azinedine456/PEMFC-Battery-HESS-FCEV-HIL-Simulation-Project/Project Report (French) - Émulation d’un véhicule électrique à stockage.pdf

## Spécialité :

## Génie Électrique - EPRM – I3

2025-2026

## UE - Projet : Réalisation et synthèse EPRM

### 1. Groupe 3

- H. Zinedine ABAYAHIA
- Melvyn TOURAILLE VARAMATA
- Aissatou BA

## Émulation d’un véhicule électrique à stockage

## hybride (FCEV HESS)

## - Groupe 3 - Emulateur de Pile à combustible et

## convertisseur Boost -

## Résumé

Ce projet s’inscrit dans le cadre de l’étude et de la modélisation d’une chaîne de traction

hybride associant une pile à combustible à membrane échangeuse de protons (PEMFC) et

une batterie, interfacées par des convertisseurs statiques de puissance. L’objectif principal

est la conception et l’implémentation d’un émulateur de pile à combustible capable de

reproduire fidèlement le comportement électrique d’une PEMFC réelle, tout en permettant

une interaction réaliste avec un bus continu imposé par une batterie.

L’approche retenue repose sur l’utilisation de deux convertisseurs DC/DC distincts : un

convertisseur abaisseur, dédié à l’émulation de la pile à combustible au travers de

différents modèles disponible sous Simscape (conditions nominales), et un convertisseur

élévateur, chargé de contrôler le courant injecté dans le bus continu. Les modèles et lois de

commande ont été développés sous l’environnement MATLAB/Simulink, en tenant

compte des contraintes de stabilité, de performance dynamique et de simplicité de mise en

œuvre en vue d’une future implémentation matérielle.

Les résultats de simulation permettent de valider la structure de commande proposée ainsi

que la séparation fonctionnelle entre l’émulation de la pile et la gestion de l’énergie

injectée dans le bus continu. Ce travail constitue une base solide pour l’extension vers des

modèles dynamiques plus complexes de PEMFC et pour une implémentation

expérimentale sur banc de test.

## Table des matières

2.2.3 | Asservissement du convertisseur Buck – Mode Tension (modèle du premier ordre)14
2.2.4 | Asservissement du convertisseur Buck – Mode Tension (modèle du second ordre) 15

References | 31
Annexe | 32

## Liste des Figures

Figure 1 : Topologie semi-active d’un véhicule FCEV hybride [4] | 7
Figure 2 : Difference entre la topologie "Full-Active" et Semi-Active[4] | 7
Figure 3 Rendement électrique (Li-Ion vs PAC)[5] | 8
Figure 4 : Réaction oxydoréduction d'une PAC MEP [8] | 9
Figure 5 : Caractéristique IV d'une PAC MEP [10] | 12

Figure 6 : Simulateur HIL basé sur le modèle du circuit électrique équivalent (Valable en

région ohmique seulement) [8] | 12
Figure 7 : Schéma global du système d'émulation [4], [12] | 13
Figure 8 : Circuit Buck | 15

Figure 9 : Analyse fréquentielle en boucle ouverte du modèle (Convertisseur + Correcteur)

Conception robuste après avoir agi sur Kp | 17
Figure 10 : Validation du dimensionnement Boost et Buck | 19
Figure 11 : Validation de l'asservissement de tension et de courant | 20

Figure 12 : Système d'émulation sous Simulink. (Le booléen RealData permet de choisir

entre les données fictives (créneaux) ou WLTC) | 20
Figure 13 : Validation du système d'émulation en simulation | 21
Figure 14 : Augmentation de la capacité du condensateur Buck | 21
Figure 15 : Modèle PAC prédéfini (133A nom) | 22
Figure 16 : Modèle PAC Ifcnom=6A | 22
Figure 17 : Alimentation reversible en courant (Réseau DC) | 26
Figure 18 : Émulateur PAC (vue d'ensemble) | 26
Figure 19 : Écran bleu de l'ordinateur lors de l'exécution en temps réel | 27

Figure 20 : Validation du dimensionnement avant le câblage final (Courant boost à gauche,

## Nomenclature

PWM/MLI | Pulse With Modulation/ Modulation de largeur d’impulsion
HESS | Hybrid Energy Storage System
FCEV | Fuel Cell Electric Vehicles
PAC | Pile à combustible
MEP | Pile à combustible à membrane échangeuse de protons (PEM en Anglais)

## Introduction

La transition vers des systèmes de transport à faibles émissions a conduit à un intérêt

croissant pour les véhicules électriques à hydrogène, appelés Fuel Cell Electric Vehicles

(FCEV). Ces architectures reposent généralement sur l’association de plusieurs sources

d’énergie au sein d’un système de stockage hybride (Hybrid Energy Storage System –

HESS), combinant une pile à combustible et une batterie électrochimique. Cette

hybridation permet de tirer parti des caractéristiques complémentaires de chaque source

afin de répondre aux contraintes dynamiques de la traction électrique tout en limitant les

sollicitations de la pile à combustible.

Dans un contexte de recherche et d’enseignement, l’expérimentation directe sur un

véhicule réel ou sur une pile à combustible physique reste complexe et coûteuse. Une

solution intermédiaire consiste alors à développer un émulateur de pile à combustible à

échelle réduite, permettant de reproduire son comportement électrique sans recourir à un

dispositif réel.

Ce projet s’inscrit dans cette démarche et vise la conception et la commande d’un

émulateur de pile à combustible destiné à une application de type FCEV, intégré à un

environnement simplifié représenté par un bus continu idéal.

Ce projet vise à concevoir un émulateur de PEMFC intégré dans une chaîne de traction

hybride, en mettant l’accent sur une modélisation réaliste du comportement électrique et

sur une architecture de commande claire et modulaire. L’approche adoptée dissocie

l’émulation de la tension de la pile et le contrôle du courant injecté dans le bus continu, ce

dernier ayant une tension imposée par la batterie.

L’ensemble des travaux est réalisé sous MATLAB/Simulink, avec une attention

particulière portée à la stabilité en boucle fermée, à la robustesse face aux variations de

charge et à la compatibilité avec une implémentation matérielle future.

## Chapitre 1. Contexte

## 1.1 Structure des véhicules électriques à stockage hybride (FCEV HESS)

Dans une architecture FCEV hybride semi-active, la batterie est directement connectée au

bus continu et assure le maintien de la tension du réseau ainsi que la fourniture de

puissance lors des transitoires rapides de courant imposés par le cycle de conduite (voir

Figure 1 et la Figure 2). La batterie permet également la récupération de l’énergie cinétique

lors des phases de freinage régénératif, ce qui impose un fonctionnement bidirectionnel en

courant [1].

La pile à combustible, alimentée par un réservoir d’hydrogène, est destinée à fournir une

puissance moyenne quasi constante et unidirectionnelle en courant. Ce mode de

fonctionnement permet d’optimiser le rendement de la pile et de limiter les sollicitations

dynamiques susceptibles d’affecter sa durée de vie [2], [3]. L’interface entre la pile à

combustible et le bus continu est assurée par un convertisseur Boost, dont le rôle est à la

fois d’adapter le niveau de tension de la PAC au réseau DC et d’asservir le courant prélevé

à la pile [4].

La chaîne de traction consomme l’énergie fournie par la pile à combustible et la batterie

conformément à la stratégie de gestion des flux de puissance mise en œuvre. En phase de

freinage régénératif, l’énergie récupérée est réinjectée vers la batterie via le bus continu.

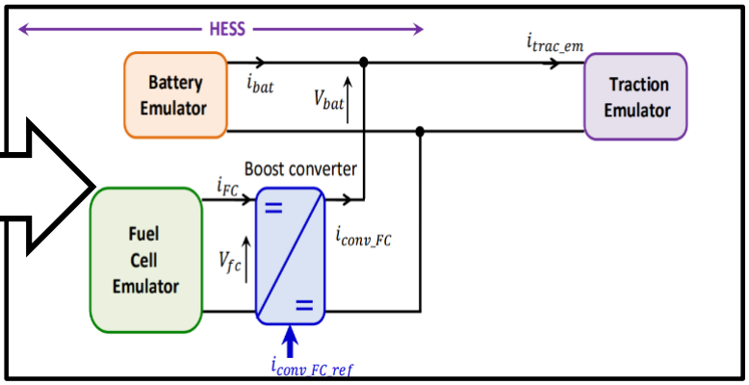
[picture p1: figure]
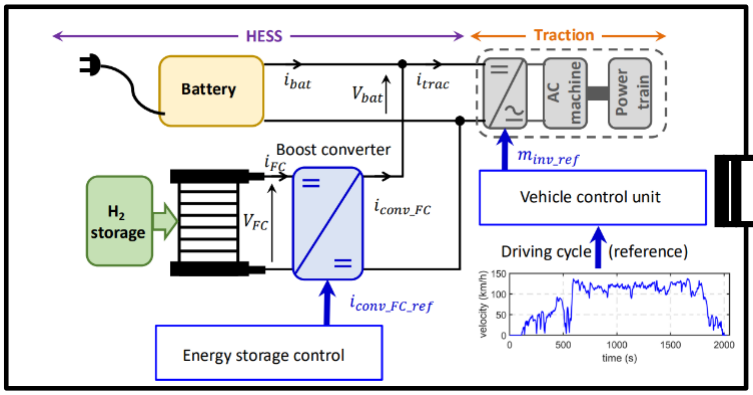
[picture p2: figure]

Figure 1 : Topologie semi-active d’un véhicule FCEV hybride [4].

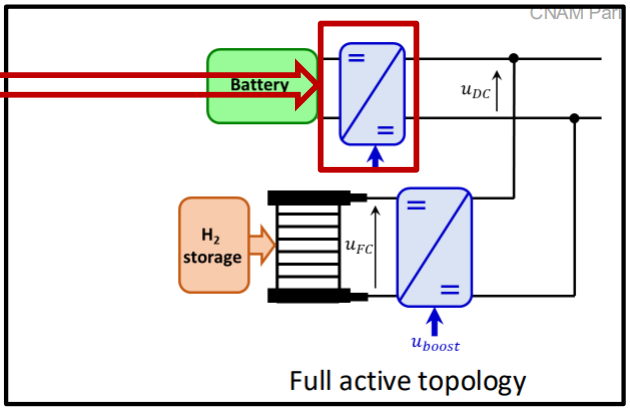
[picture p3: figure]
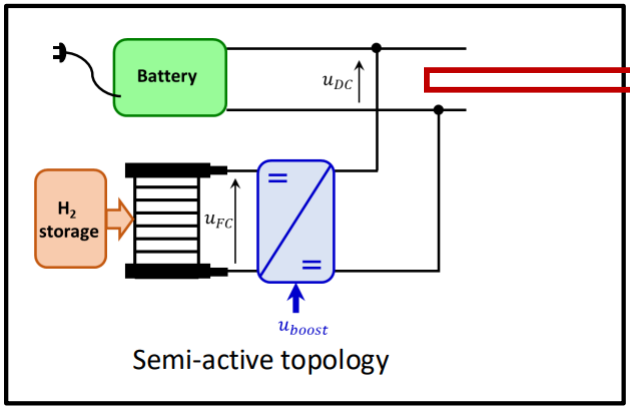
[picture p4: figure]

Figure 2 : Difference entre la topologie "Full-Active" et Semi-Active[4].

## 1.2 Rôle de la pile à combustible vis-à-vis de la batterie

Dans un FCEV HESS, la répartition des rôles entre la pile à combustible et la batterie est

dictée par leurs caractéristiques intrinsèques. La batterie Li-Ion présente un très bon

rendement énergétique et une capacité à répondre rapidement aux variations de courant, ce

qui la rend adaptée à la compensation des pics de puissance liés aux accélérations et aux

phases de récupération d’énergie au freinage [5]. En revanche, sa densité énergétique reste

limitée (par rapport à la PAC) et son vieillissement est fortement dépendant des cycles de

charge et de décharge [5], [6].

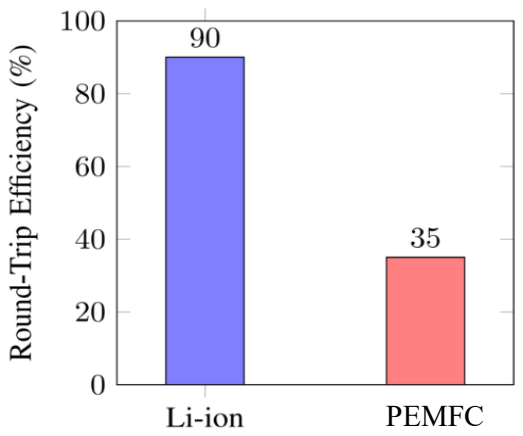
[picture p5: figure]
PEMFC
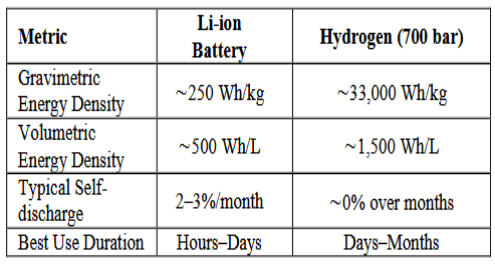
[picture p6: figure]

La pile à combustible MEP, quant à elle, offre une densité énergétique élevée grâce à

l’hydrogène, mais présente une dynamique lente et une sensibilité marquée aux variations

rapides de courant [7]. Pour cette raison, il est généralement admis que la PAC doit

fonctionner autour d’un point de fonctionnement relativement stable, fournissant un flux de

puissance quasi constant. Toute sollicitation dynamique excessive est susceptible

d’entraîner une dégradation accélérée des performances électrochimiques et mécaniques de

la pile ce qui est lié majoritairement à la dégradation du catalyseur de la MEP [2], [3].

Dans l’architecture étudiée, la batterie assure donc le maintien du bus continu et la gestion

des transitoires, tandis que la pile à combustible alimente le système sur le long terme.

Cette complémentarité justifie le stockage hybride malgré la complexification du groupe

motopropulseur.

Figure 3 Rendement électrique (Li-Ion vs PAC)[5].

Tableau 1 : Comparaison entre la densité de puissance des batteries LI-ION avec les PAC MEP [5].

## Chapitre 2. Partie théorique

## 2.1 Modélisation de la pile à combustible PEM (conditions nominales)

La modélisation de la pile à combustible constitue une étape essentielle pour le

développement d’un émulateur réaliste. Dans le cadre de ce projet, la modélisation est

réalisée sous conditions nominales de fonctionnement, sans prise en compte explicite des

phénomènes de dégradation liés aux ondulations de courant ou au vieillissement à long

terme.

### 2.1.1 Modèle complet, réactions électrochimiques

Une pile à combustible PEM repose sur la réaction électrochimique entre l’hydrogène et l’oxygène pour produire de l’électricité, de la chaleur et de l’eau. À l’anode, l’hydrogène

est oxydé selon la réaction (voir la Figure 4). Ces réactions dépendent de de la température,

de la pression et de l’humidité relative. Pour cette étude, les conditions nominales de la

cellule avaient été prises et le combustible étant inépuisable afin d’éviter les

problématiques d’approvisionnement et de débit.

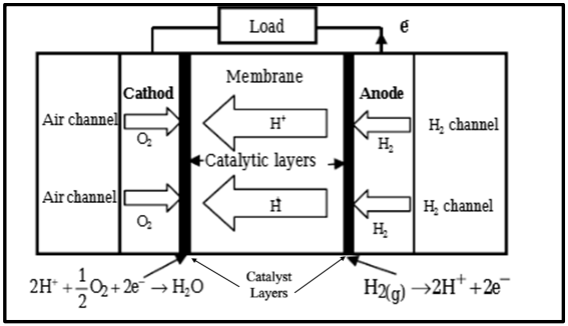
[picture p7: figure]

Figure 4 : Réaction oxydoréduction d'une PAC MEP [8].

La tension idéale de la cellule est déterminée par l’équation de Nernst (2.1.1)[9]

(2.1.1)

Tandis que la tension réelle est affectée par plusieurs chutes de tensions :

Chute d’activation Vact, qui représente la tension requise pour lancer les réactions

chimiques dans l’anode et la cathode (briser et créer les liaisons chimiques) (effet prononcé

pour des courants faibles) [9]

(2.1.2)

La chute de concentration Vcon , qui représente la concentration des gradients créés par la

diffusion des masses depuis les canaux d’approvisionnement jusqu’aux électrodes (effet

prononcé pour des courants forts) [9].

(2.1.3)

La chute de tension ohmique Vohm ,liée a la résistance série des électrodes et de la

membrane MEP[9].

Voℎm = Ifc. Roℎm | (2.1.4)

De plus, la PAC MEP présente un comportement capacitif lié à l’accumulation des charges

entre la membrane et les deux électrodes (double-layer charging effect)[9].

(2.1.5)

(2.1.6)

La tension aux bornes de la PAC est déterminée par l’équation

(2.1.7)

Paramètres électriques globaux

Paramètre | Symbole | Définition
Tension de la pile | Vfc | Tension de sortie de la pile à combustible PEM
Courant de la pile | Ifc | Courant délivré par la pile
Courant limite | Il | Courant maximal atteignable lorsque la réaction est limitée par le transport de matière
Courant d’échange | I0 | Courant électrochimique à l’équilibre

Paramètres thermodynamiques et constants physiques

Paramètre | Symbole | Définition

Paramètre | Symbole | Définition
Constante de Faraday | F | Charge électrique par mole d’électrons (96485 C/mol)
Constante des gaz parfaits | R | Constante universelle des gaz
Température de fonctionnement | T | Température de la pile PEM

Paramètres liés aux pressions et aux gaz réactifs

Paramètre | Symbole | Définition
Pression de l’hydrogène | PH2 | Pression partielle de l’hydrogène à l’anode
Pression de l’oxygène | PO2 | Pression partielle de l’oxygène au cathode
Pression de l’eau | PH2O | Pression partielle de la vapeur d’eau
Constantes expérimentales | B1 , B2

### 2.1.2 Modèle courant–tension (I–V)

Dans une optique d’émulation temps réel, un modèle simplifié basé sur la caractéristique

courant–tension de la pile est souvent privilégié. Cette caractéristique présente trois zones

principales :

- La zone d’activation, dominée par les pertes cinétiques aux faibles courants ;
- La zone ohmique, où la tension décroît de manière quasi linéaire avec le courant ;
- La zone de concentration, associée aux limitations de transport de masse à forts

courants.

Les zones d’activation et de concentration correspondent à des régimes de fonctionnement

à éviter, car elles entraînent une baisse significative du rendement et une sollicitation

accrue de la pile [10], [11]. Le comportement global de la PAC peut être assimilé à une

simple source idéale avec une résistance série en région ohmique ou un « Look up » 1D

entre le courant et la tension sur la totalité de la plage de fonctionnement. Cela dit, les

caractéristiques courant-tension ne suffisent pas pour modéliser la dynamique de la pile

[1], [5], [7].

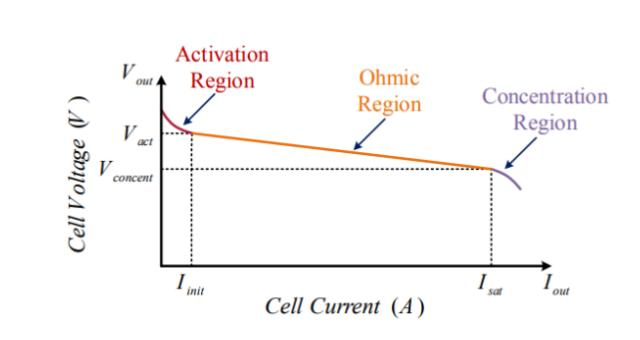
[picture p8: figure]

Figure 5 : Caractéristique IV d'une PAC MEP [10].

## 2.2 Émulateurs de pile à combustible

Un émulateur de pile à combustible vise à reproduire le comportement électrique d’une

PAC réelle à l’aide de sources électriques pilotées, des convertisseurs statiques ou des

circuits électriques spécialisés. Plusieurs approches sont recensées dans la littérature, allant

de modèles purement électriques basés sur des circuits équivalents à des structures plus

complexes intégrant des modèles dynamiques avancés.

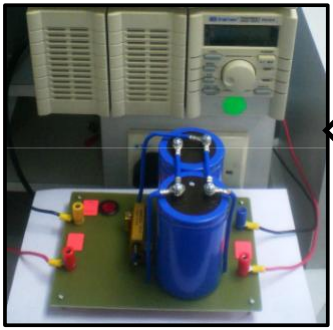
[picture p9: figure]
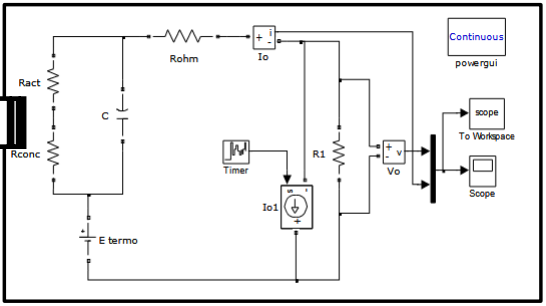
[picture p10: figure]

Afin de modéliser la dynamique de la PAC, et compte tenu du fait que la capacité d’un

MEP typique est de l’ordre du farad (environ 1 F [8]), ainsi que de l’indisponibilité de

condensateurs de telles valeurs en salle de travaux pratiques, l’émulation est réalisée dans

ce projet à l’aide de convertisseurs DC–DC commandés. Ces convertisseurs permettent

d’imposer une tension ou un courant conforme au modèle de la PAC, tout en assurant une

interface efficace avec le bus continu du HESS.

### 2.2.1 Structure retenue pour l’émulation (Système PAC – Bus DC)

L’architecture retenue est un convertisseur Buck asservi en tension associé a un boost

asservi en courant et connecté au bus DC représenté par une source idéale (voir la Figure

7).

Figure 6 : Simulateur HIL basé sur le modèle du circuit électrique équivalent (Valable en région ohmique seulement) [8].

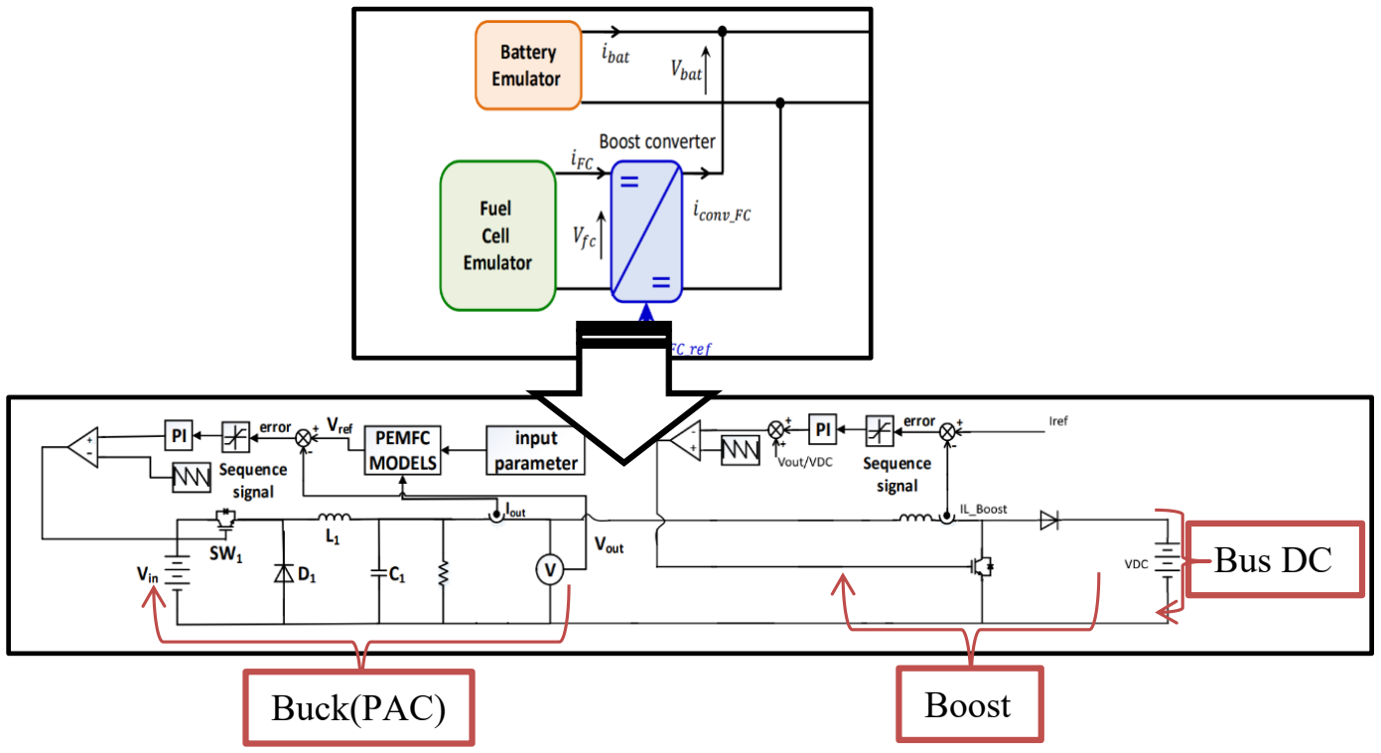
[picture p11: figure]
Buck(PAC); Boost; Bus DC

Cette structure présente l’avantage de coupler dynamiquement les courants des deux

convertisseurs. En effet, le courant absorbé par le convertisseur Boost est directement lié

au courant circulant dans l’inductance du convertisseur Buck. Par conséquent,

l’asservissement de cette grandeur permet indirectement de contrôler le courant du Buck,

ce qui a conduit au choix d’une commande en mode tension afin de simplifier la structure

de contrôle globale.

Néanmoins, cette architecture présente un inconvénient majeur : l’absence de protection

intrinsèque contre les courts-circuits du côté du condensateur de sortie du convertisseur

Buck.

### 2.2.2 Dimensionnement des composants convertisseur Buck (CCM

Seulement)

Le dimensionnement des composants passifs du convertisseur Buck est réalisé à partir des

contraintes sur les ondulations de courant dans l’inductance et sur les ondulations de

tension aux bornes du condensateur de sortie.

L’expression de l’ondulation de courant dans l’inductance du convertisseur Buck peut être

établie à partir du principe d’équilibre volt-seconde appliqué à l’inductance (voir (2.1.8)).

ΔILbuck =

(1 − αΔmax)αΔmaxEbuck

Lbuckfdec

(2.1.8)

Figure 7 : Schéma global du système d'émulation [4], [12]

L’expression de l’ondulation de tension aux bornes du condensateur de sortie peut être

obtenue à partir du principe d’équilibre ampère-seconde appliqué au condensateur, en

intégrant le courant capacitif sur une demi-période de découpage (voir (2.1.9)).

ΔVSbuck =

ΔILbuck

8Cbuckfdec

(2.1.9)

Paramètres

ParamètreDescription

ΔILbuck | Ondulation de courant dans l'inductance du convertisseur buck.
αΔmax | Facteur de modulation lié à l’amplitude maximale de l’ondulation du courant.
Ebuck | Tension d'entrée du convertisseur buck.
Lbuck | Inductance du convertisseur buck.
fdec | Fréquence de découpage (ou fréquence de commutation) du convertisseur.
ΔVSbuck | Ondulation de tension aux bornes du condensateur de sortie.
Cbuck | Capacité du condensateur de sortie du convertisseur buck.

### 2.2.3 Asservissement du convertisseur Buck – Mode Tension (modèle du

premier ordre)

Certaines hypothèses doivent être posées afin de modéliser un circuit Buck comme un

système du premier ordre.

Hypothèses et assertions :

1. Modèle au sens des valeurs moyennes (tension aux bornes de la diode vaut α(t). E).
2. Cbuck suffisamment grand afin de pouvoir négliger les ondulations de tension.
3. Dynamique du condensateur négligée durant une période de découpage (<ic> =ic=0

et Il=Il’ voir la Figure 8).

4. Le courant tiré par le convertisseur boost est considéré comme une perturbation.

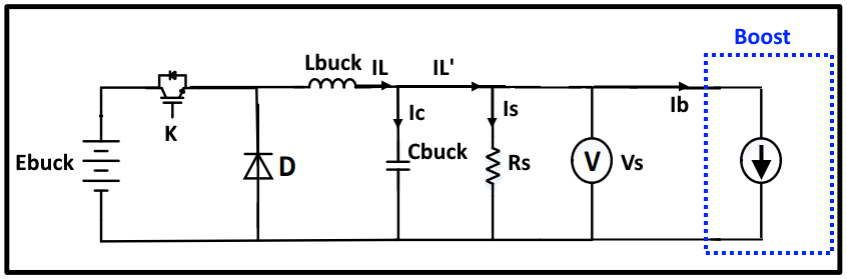
[picture p12: figure]

Figure 8 : Circuit Buck.

En prenant en compte les hypothèses ci-dessus, l’expréssion de la tension peut etre établie

comme suit

Vs(s) =

ERs
Rs + RL
L
Rs + RL

s + 1

α(s) −

RLRs
Rs + RL

(

L
RL

s + 1)

L
RL +Rs

s +1

Ib(s)

(2.1.10)

En négligeant la perturbation, voici la fonction de transfert du système à asservir devient :

Vs(s)
α(s)

|Ib(s)=0 =

ERs
Rs + RL
L
Rs + RL

s + 1

=

Kbuck

τbucks + 1

(2.1.11)

En employant la méthode d’annulation pole-zéro, les gains peuvent être calculés pour un

correcteur PI afin d’imposer un temps de réponse TR5% qui répond au cahier des charges.
{
Kibuck =

3

TR5%buckKbuck
Kpbuck = τbuckKibuck

(2.1.12)

Cette méthode présente toutefois plusieurs inconvénients. En premier lieu, aucune valeur

de la résistance série Rs ne permet de garantir formellement que le convertisseur se

comporte strictement comme un système du premier ordre, comme discuté à la section

2.2.4. De plus, il n’existe pas de critère permettant de déterminer une valeur optimale de

Rsassurant une réduction significative de l’impact des perturbations sans dégrader le

rendement du convertisseur. En pratique, cela conduit à l’utilisation d’une résistance Rsde

faible valeur, au prix d’une augmentation des pertes (Courant Is > 2Ib). Enfin, la

dynamique de la perturbation observée expérimentalement diffère de celle anticipée lors de

l’analyse théorique, comme détaillé à la section 3.1.1.

### 2.2.4 Asservissement du convertisseur Buck – Mode Tension (modèle du

second ordre)

Certaines hypothèses doivent être posées afin de modéliser un circuit Buck comme un

système du second ordre sur-amorti.

Hypothèses et assertions :

1. Modèle au sens des valeurs moyennes (tension aux bornes de la diode vaut α(t). E).

A partir des hypothèses précédentes et de la loi des mailles, l’expression de Vs(s) peut

être établie.

Vs(s) =

E

LCs

2 +(

L
Rs + RL) s +

RL
Rs + 1

α(s) −

(

L
RL

s + 1) RL

LCs

2 + (

L
Rs + RL) s +

RL
Rs + 1

Ib(s)

(2.1.13)

Pour RL = 0Ω :

Vs(s) =

E

LCs

2 + (

L
Rs) s + 1

α(s) −

(Ls + 1)

LCs

2 +(

L
Rs) s + 1

Ib(s)

(2.1.14)

L’objectif est d’amortir le système en imposant un coefficient l ≥ 10 afin d’avoir P2 = P1. l

(pole rapide) et donc un comportement semblable à un 1er ordre.

Vs(s)
α(s)

|Ib(s)=0 =

Kbuck ωn²
(s + P1)(s + P1. l)

(2.1.15)

{

ζsur−amortissment =

1
√1 − (
l − 1
l + 1

)

2

Rsoptimal =

1

2ζsur−amortissment √
Lbuck

Cbuck

(2.1.16)

Par la suite, le pôle P1 sera annulé par le pôle Pi =Ki/Kp du correcteur PI (rapport Ki/Kp

fixe). Puis le gain Kp sera employé afin d’agir sur la marge de phase pour satisfaire les

critères suivants (voir la Figure 9) :

- Marge de gain > 6dB
- Marge de phase > 45°

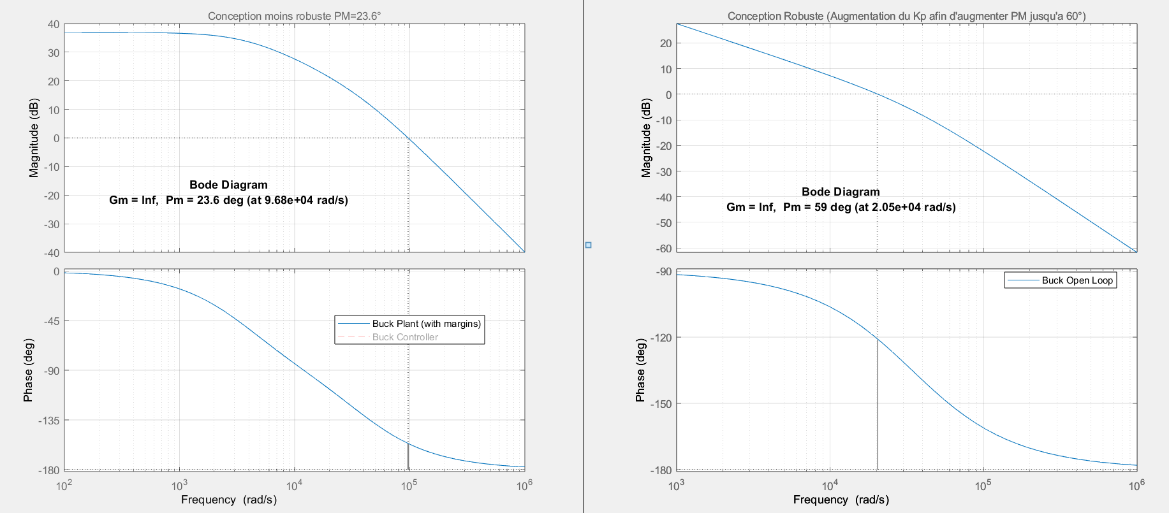
[picture p13: figure]

De plus, le temps de réponse sera analysé afin de vérifier qu’il correspond à notre cahier de

charge.

Cette méthode présente plusieurs avantages, notamment la possibilité de déterminer une

valeur optimale de la résistance Rset de garantir une commande robuste par l’augmentation

de la marge de phase du système. De plus, le modèle représente de manière fidèle la

dynamique de la perturbation 3.1.1.

### 2.2.5 Dimensionnement des composants convertisseur Boost (CCM

Seulement)

Le dimensionnement des composants passifs du convertisseur Boost est réalisé à partir des

contraintes sur les ondulations de courant dans l’inductance.

L’expression de l’ondulation de courant dans l’inductance du convertisseur Boost peut être

établie à partir du principe d’équilibre volt-seconde appliqué à l’inductance

ΔIb =

αVFC

Lboostfdec

(2.1.17)

### 2.2.6 Asservissement du convertisseur Boost

Certaines hypothèses doivent être posées afin d’asservir le circuit Boost.

Hypothèses et assertions :

- Modèle au sens des valeurs moyennes (tension aux bornes du transistor vaut

α(t). VDC).

Figure 9 : Analyse fréquentielle en boucle ouverte du modèle (Convertisseur + Correcteur) Conception robuste après avoir agi sur Kp.

- La dynamique de VDC peut être considérée comme lente ou négligeable vis-à-

vis de la dynamique du courant inductif (système du premier ordre).

En prenant en compte les hypothèses ci-dessus, l’expréssion de la fonction de

transfert du courant peut etre établie comme suit

Ib

(s)
−(2α(s) − 1)

=

VDC
RLboost
L
RLboost

s + 1

=

Kboost
τboosts+1

(2.1.18)

En employant la méthode d’annulation pole-zéro, les gains peuvent être calculés pour un

correcteur PI afin d’imposer un temps de réponse TR5% qui répond au cahier des charges.
{
Kiboost =

3

TR5%boostKboost
Kpboost = τboostKiboost

(2.1.19)

Afin de contrôler directement la puissance fournie par la pile à combustible, le

convertisseur Boost est commandé en courant. La grandeur asservie est le courant inductif

ib, qui correspond au courant prélevé à la PAC. La puissance fournie par la pile est alors

donnée par :

PFC = VFC × ib | (2.1.20)

Cette approche présente plusieurs avantages majeurs. Elle permet d’imposer directement le

point de fonctionnement de la PAC sur sa caractéristique courant–tension ainsi que de

limiter les ondulations de courant côté pile.

## 2.3 Gestion des flux de puissance

La gestion des flux de puissance constitue un prolongement naturel de l’émulateur de

FCEV. Une stratégie de type « charge sustaining » est généralement adoptée, visant à

maintenir l’état de charge de la batterie autour d’une valeur de consigne tout au long du

cycle de conduite [11].

Dans ce cadre, la pile à combustible fournit la puissance moyenne requise par le véhicule,

tandis que la batterie absorbe ou fournit la puissance différentielle liée aux transitoires.

Cette approche permet de reproduire fidèlement le fonctionnement d’un FCEV réel.

## Chapitre 3. Simulation

## 3.1 Méthode de travail

La démarche adoptée repose principalement sur la simulation de l’ensemble du système

afin d’accélérer le prototypage et d’analyser le comportement global avant toute

expérimentation. Des tests unitaires ont également été réalisés pour isoler les sous-

systèmes, faciliter le débogage et sécuriser l’intégration finale.

### 3.1.1 Tests unitaires

Des simulations en boucle ouverte sont réalisées afin de valider le dimensionnement de chaque convertisseur. L’asservissement est ensuite validé en trois étapes successives :

- Buck – mode tension
Cahier des charges : dépassement nul, T5% ≤ 1ms.
- Boost – mode courant
Cahier des charges : dépassement nul, T5% ≤ 1ms.
- Système complet
Validation réalisée avec des profils de puissance fictifs, puis à l’aide d’un cycle WLTC normalisé par rapport au courant nominale de l’émulateur physique (6A).

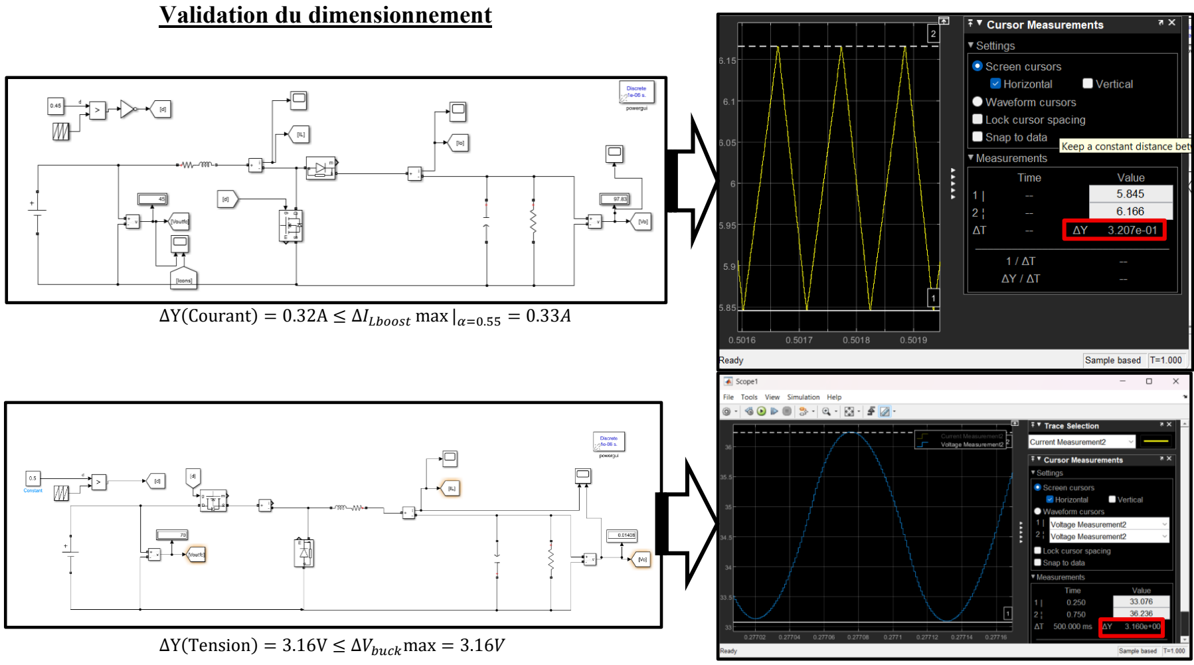
[picture p14: figure]
Validation du dimensionnement; ΔY(Tension) = 3.16V ≤ ΔVbuckmax = 3.16V

ΔY(Courant) = 0.32A ≤ ΔILboost max |α=0.55 = 0.33A

Figure 10 : Validation du dimensionnement Boost et Buck.

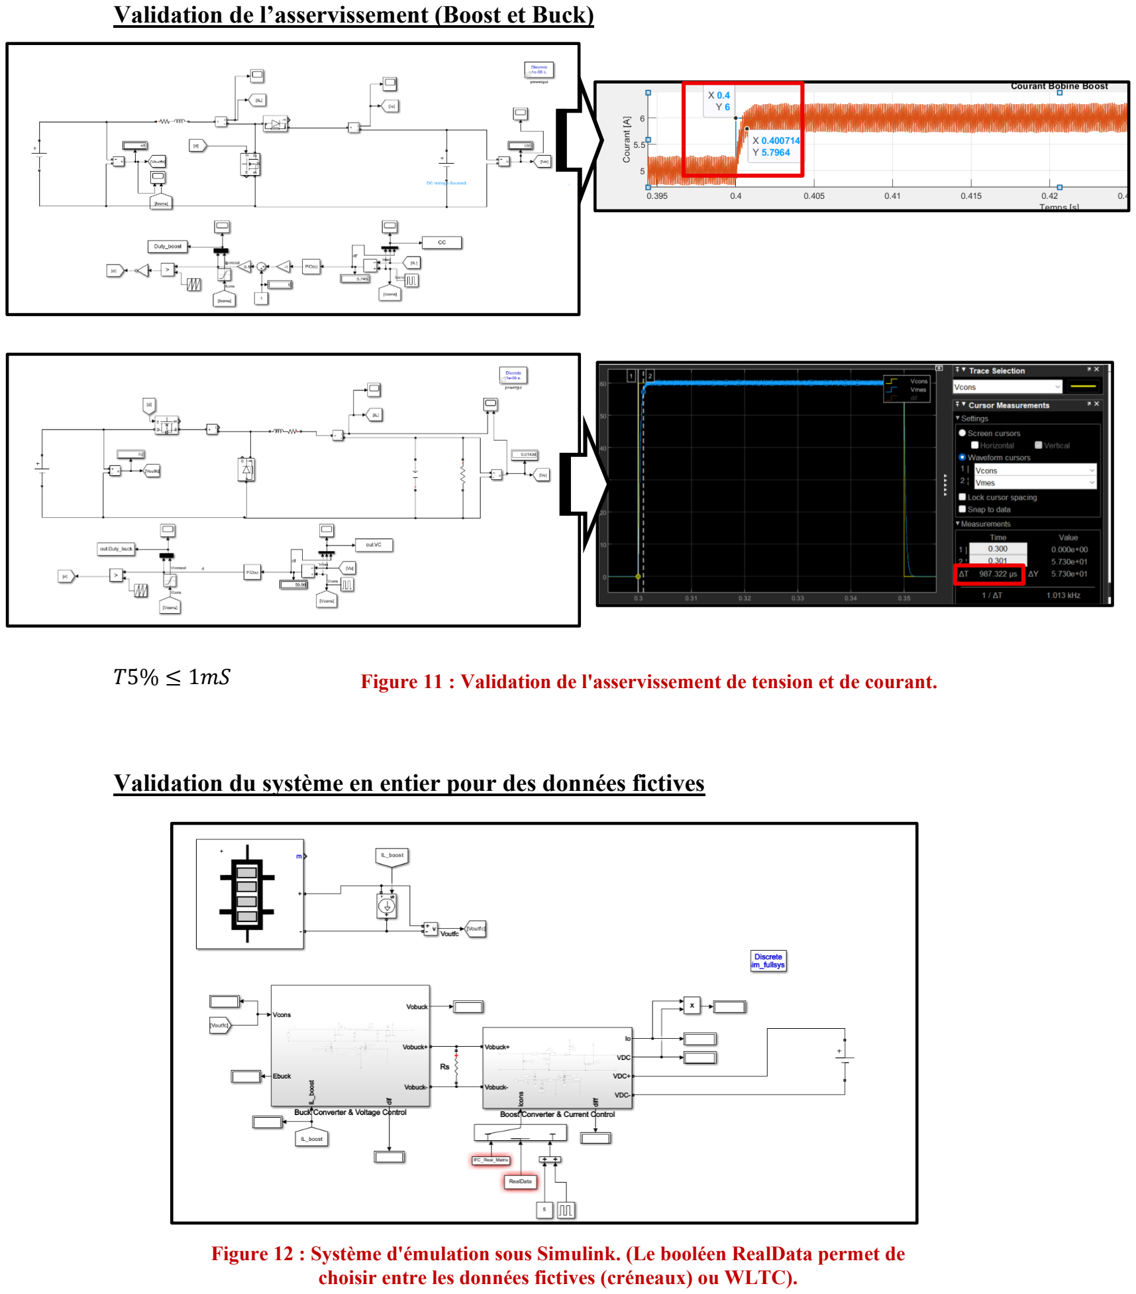
[picture p15: page 20]

Validation de l’asservissement (Boost et Buck)

T5% ≤ 1mS

Validation du système en entier pour des données fictives

Figure 11 : Validation de l'asservissement de tension et de courant.

Figure 12 : Système d'émulation sous Simulink. (Le booléen RealData permet de choisir entre les données fictives (créneaux) ou WLTC).

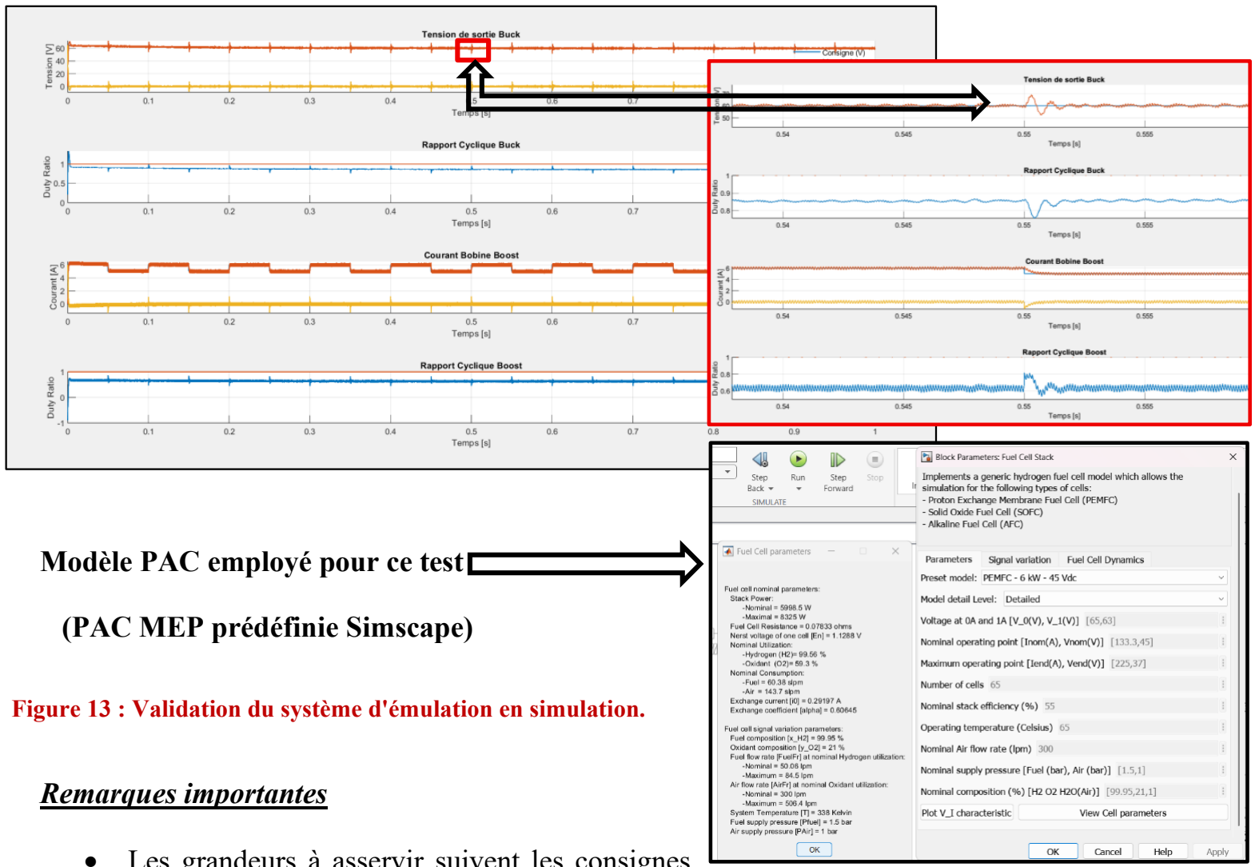
[picture p16: figure]
Modèle PAC employé pour ce test; (PAC MEP prédéfinie Simscape); Remarques importantes

- Les grandeurs à asservir suivent les consignes

selon le cahier des charges.

- La dynamique de la perturbation (ondulation de tension induite par les appels de

courants vu sur la Figure 13) est semblable à un système du second ordre avec un

zéro. Ce qui confirme que le modèle de la section 2.2.4 est plus réaliste.

- Afin de réduire l’impact de cette perturbation, il suffit d’augmenter la capacité du

condensateur Buck (voir la Figure 14).

Figure 13 : Validation du système d'émulation en simulation.

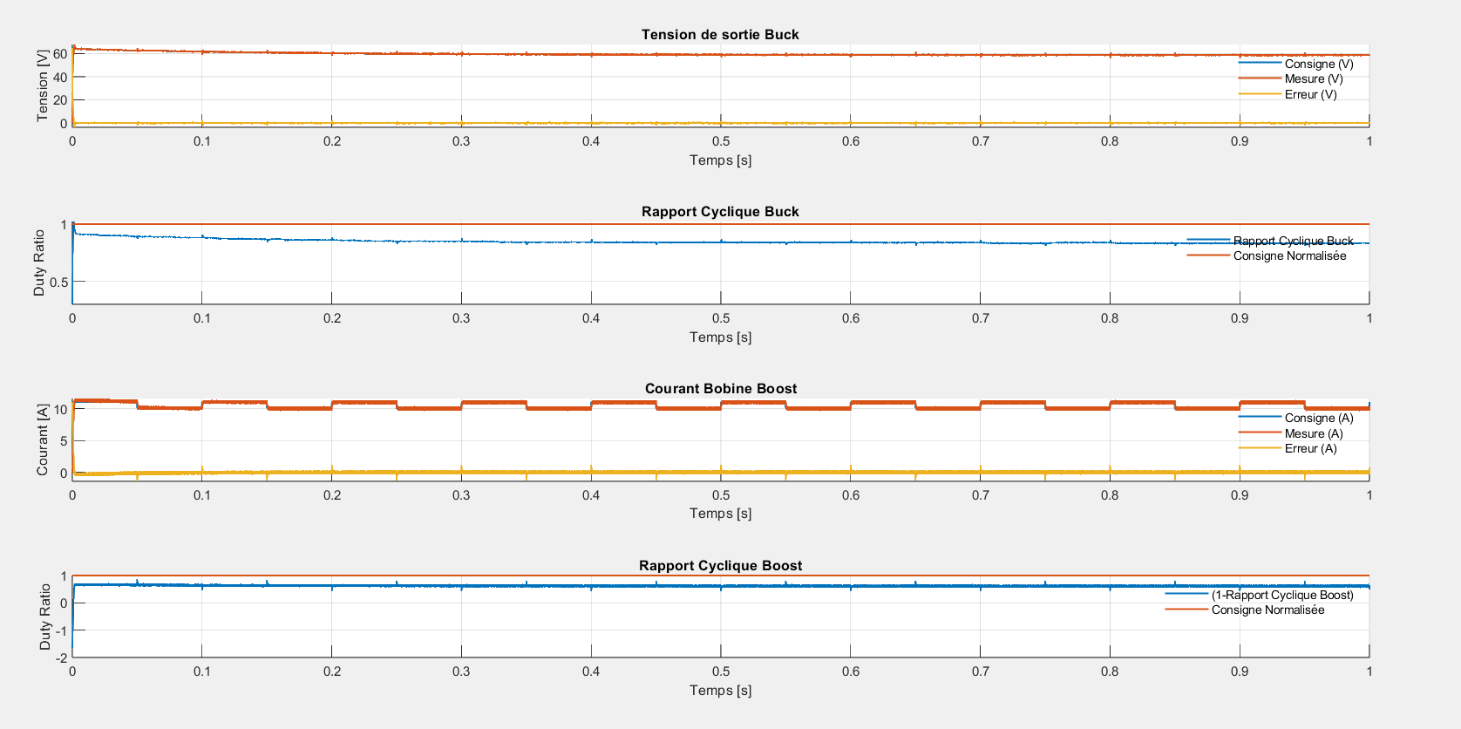
[picture p17: figure]

Figure 14 : Augmentation de la capacité du condensateur Buck.

## 3.2 Résultats de simulation avec données WLTC

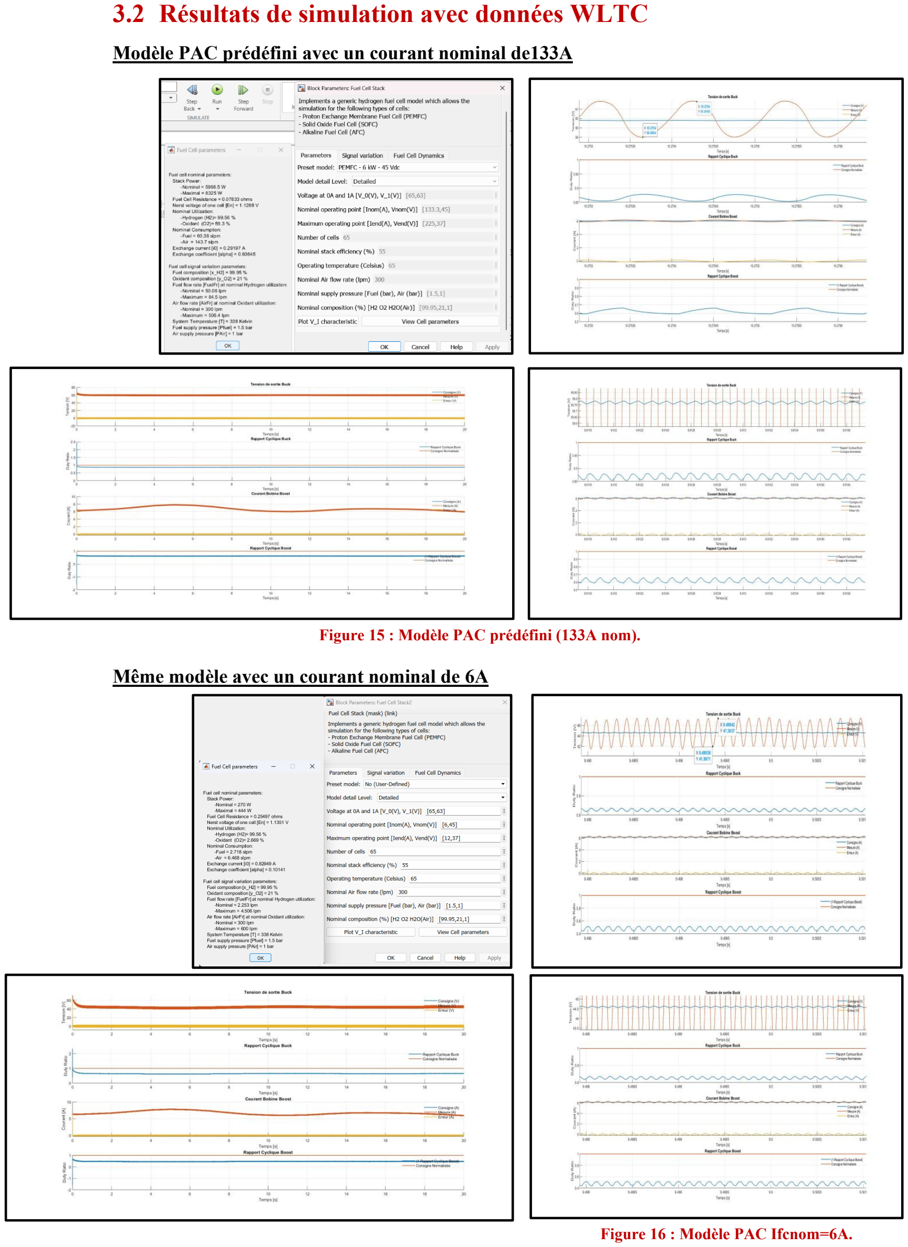
[picture p18: page 22]

Modèle PAC prédéfini avec un courant nominal de133A

Même modèle avec un courant nominal de 6A

Figure 15 : Modèle PAC prédéfini (133A nom).

Figure 16 : Modèle PAC Ifcnom=6A.

### 3.2.1 Discussion

Le système développé est capable de suivre le courant de consigne issu du cycle WLTC

ainsi que la consigne générée par le modèle de pile à combustible à membrane échangeuse

de protons (PEM). Les ondulations de courant imposées par le convertisseur Boost sont

directement prélevées sur la pile à combustible et se répercutent sur la tension fournie par

le modèle PAC, une attention particulière doit être portée à leur amplitude, celles-ci étant

susceptibles de contribuer à la dégradation de la pile à combustible, comme indiqué dans la

littérature [2], [3]. De plus, il est apparent que plus la résistance série augmente (courant

nominal plus bas) l’ondulation de tension induite par l’ondulation du courant boost est plus

important.

La dynamique de perturbation mise en évidence lors des tests avec des profils fictifs

n’apparaît pas de manière significative lors des simulations basées sur le cycle WLTC. Ce

comportement s’explique par le caractère relativement progressif des variations de courant

du cycle WLTC, nettement moins brusques que celles imposées artificiellement lors des

phases de validation préliminaire.

## Chapitre 4. Implémentation

## 4.1 Définition des ordres de grandeurs

La définition des ordres de grandeurs constitue une étape essentielle dans la mise en œuvre

de l’émulateur de pile à combustible. En effet, elle permet de fixer des valeurs cohérentes

de tension, de courant et de puissance afin d’assurer le bon fonctionnement du système.

Dans le cadre de ce projet, l’émulation est effectuée à échelle réduite. Il est donc nécessaire

de choisir des ordres de grandeurs réalistes pour une pile à combustible utilisée dans une

application de type FCEV. Ces valeurs doivent toutefois rester compatibles avec les limites

du matériel disponible en laboratoire. Cela permet de travailler dans des conditions

réalistes sans dépasser les limites des convertisseurs et des composants utilisés.

La définition des ordres de grandeurs permet également d’assurer la cohérence entre le

modèle de la pile à combustible, les lois de commande et le comportement attendu de

l’émulateur. Elle facilite ainsi l’analyse du fonctionnement du système et la validation des

convertisseurs Buck et Boost mis en œuvre dans le cadre du projet.

Dans un premier temps, des ordres de grandeurs initiaux ont été définis à partir de valeurs

typiques de véhicules électriques à hydrogène réels. Une puissance de référence d’environ

35 kW et une tension de bus de 400 V ont ainsi été considérées, puis ramenées à une

échelle de laboratoire selon le support de cours. La puissance a été divisée par un facteur

d’environ 100, conduisant à une puissance de l’ordre de 350 W, tandis que la tension du

bus a été ramenée à une valeur proche de 48 V, ce qui permet d’estimer un courant

maximal de l’ordre de 7 à 8 A. Les paramètres liés à la chute de tension interne, à la rampe

de puissance et au rendement ont également été choisis à partir de valeurs typiques de piles

à combustible de type PEMFC.

Ces valeurs initiales ont servi de base pour le dimensionnement de l’émulateur et la mise

en place des premiers modèles et lois de commande. Cependant, les premières simulations

ont montré que ces choix n’étaient pas totalement adaptés en termes de stabilité et de

dynamique du convertisseur Buck. Les ordres de grandeurs ont donc été ajustés afin

d’obtenir un fonctionnement plus stable et mieux maîtrisé. Les valeurs finales retenues,

présentées dans la suite du rapport, permettent ainsi de concilier réalisme du comportement

de la pile à combustible, contraintes matérielles et faisabilité expérimentale.

Les ordres de grandeurs ont également été définis de manière à rester cohérents avec les

autres sous-systèmes du projet, à savoir les parties Batterie et chaîne de traction étudiées

par les autres groupes. La batterie présente une tension de sortie de l’ordre de 40 V pour un

courant maximal de 5 A, tandis que la chaîne de traction repose sur un convertisseur Boost

avec une tension de sortie visée de l’ordre de 60 V. Dans ce contexte, la tension nominale

choisie pour l’émulateur de pile à combustible, d’environ 45 V, reste cohérente avec

l’architecture globale du système.

Les valeurs retenues finalement pour ce projet sont les suivantes :

Paramètres du convertisseur Buck

Paramètre | Valeurs | Unité | Paramètre | Valeur | Unité
T5buck | 0.001000 | s | εbuck | 1.739253 | –
Ebuck | 70.000000 | V | εfirst_buck | 1.739253 | –
Vnom_buck | 45.000000 | V | ωn_buck | 10800.00 | rad/s

Paramètre | Valeurs | Unité | Paramètre | Valeur | Unité
Lbuck | 0.006481 | H | P1buck | −34152.598730 | rad/s
Rs_buck | 20 | Ω | P2buck | −3415.259873 | rad/s
Cbuck | 1.322751e-06 | F | PPibuck | 3415.259873 | rad/s
fdec_buck | 9000 | Hz | T5calc_buck | 0.000878 | s

Marges de stabilité – Convertisseur Buck

Marge | Valeur | Fréquence associée
Marge de gain | Inf dB | Inf rad/s
Marge de phase | 59.03° | 20498.16 rad/s

Paramètres du convertisseur Boost – Dimensionnement et commande

Paramètre | Valeur | Unité
T5boost | 0.001000 | s
Eboost | 45.000000 | V
VDC_boost | 100.000000 | V
Lboost | 0.008333 | H
Rl_boost | 0.100000 | Ω
fdec_boost | 9000 | Hz
Kp_boost | 0.250000 | –
Ki_boost | 3.000000 | –

Spécifications des ondulations de courant et de tension

Grandeur | Expression | Valeur numérique | Grandeur | Expression | Valeur

Grandeur | Expression | Valeur numérique | Grandeur | Expression | Valeur
VDC_boost | — | 100 V | Vnom_buck | — | 45 V
Inom_boost | — | 6 A | Inom_buck | — | 6A
ΔIboost | 0.1 ⋅ Inom_boost | 0.6 A | ΔIbuck | 0.05 ⋅ Inom_buck | 0.3A
ΔVboost | 0.1 ⋅ VDC_boost | 10 V | ΔVbuck | 0.07 ⋅ Vnom_buck | 3.15 V

## 4.2 Présentation de l’alimentation réversible et de l’émulateur physique

Dans le cadre de l’émulation de la pile à combustible, une alimentation réversible est

utilisée afin de permettre un échange d’énergie bidirectionnel avec le bus continu. Ce type

d’alimentation est capable de fonctionner aussi bien en mode source qu’en mode charge, ce

qui la rend particulièrement adaptée aux applications de conversion de puissance et

d’émulation de sources électriques.

Une alimentation réversible permet de fournir une tension contrôlée au système, tout en

étant capable d’absorber l’énergie lorsque le fonctionnement l’exige. Elle permet d’adapter

facilement les conditions de fonctionnement tout en assurant la sécurité des équipements.

Dans le contexte de ce projet, ce dispositif a été envisagé pour pouvoir représenter

l’environnement électrique du système et faciliter les tests des convertisseurs DC–DC dans

des conditions contrôlées.

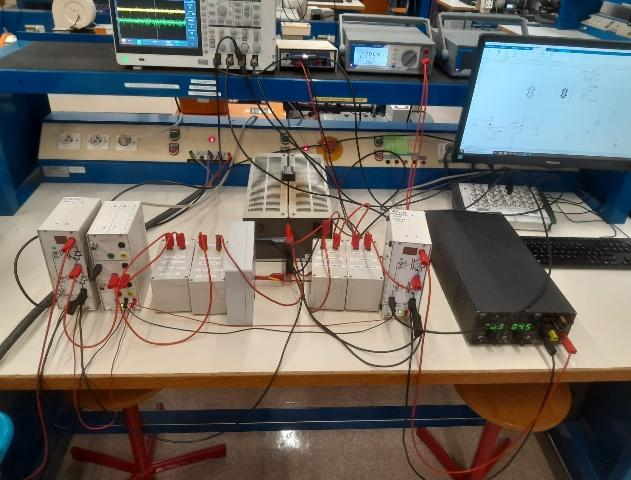
[picture p19: figure]
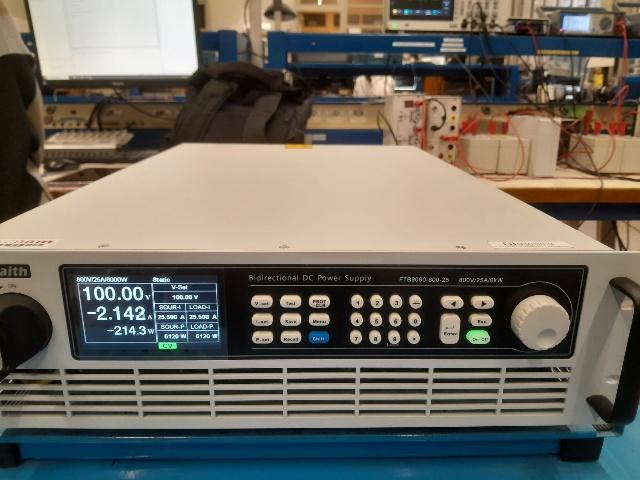
[picture p20: figure]

Figure 18 : Émulateur PAC (vue d'ensemble). | Figure 17 : Alimentation reversible en courant (Réseau DC).

## 4.3 Problèmes techniques lors de la manipulation

Lors de la réalisation du projet, des problèmes de stabilités ont été rencontrés lors des

simulations. Ils étaient principalement liés à l’utilisation des blocs To Workspace pour

sauvegarder les données en temps réel, ce qui sollicitaient fortement le système.

De plus, le temps de calcul imposé (25µS) était trop faible par rapport à la complexité du

schéma, ce qui ne permettait pas au système d’exécuter l’ensemble des calculs dans le

temps imparti.

La carte utilisée en salle de travaux pratiques est une carte d’interfaçage de type

Humusoft, directement reliée au processeur de l’ordinateur. L’ensemble des calculs étant

réalisé par le processeur du PC et non par la carte elle-même, la charge de calcul était donc

trop importante, ce qui a entraîné des plantages du PC.

Ces contraintes ont nécessité une adaptation de la méthode de travail, en limitant

l’enregistrement des données en temps réel et en ajustant les paramètres de simulation.

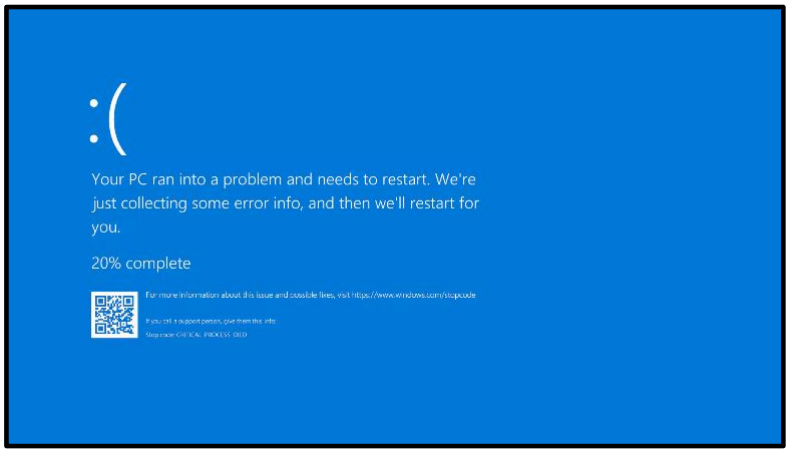
[picture p21: figure]

Figure 19 : Écran bleu de l'ordinateur lors de l'exécution en temps réel

## 4.4 Résultats de la manipulation

### 4.4.1 Discussion

Les résultats obtenus ont été constatés comme étant globalement en accord avec la

simulation (Figure 20, Figure 21, Figure 24 et Figure 23). Sur la Figure 25 cependant, la

perturbation liée à l’appel de courant n’a pas été observée, contrairement à ce qui avait été

simulé, ce qui pourrait indiquer un niveau d’amortissement plus élevé sur notre câblage.

Sur la Figure 22, il a été mis en évidence que la conception intégrant la dynamique du

condensateur — modélisée comme un système du second ordre légèrement sous-amorti

pour le Buck — avec une marge de phase appropriée et une valeur optimale de Rsest

efficace. Il a également été observé que le choix incorrect de Rsentraîne l’apparition

d’oscillations.

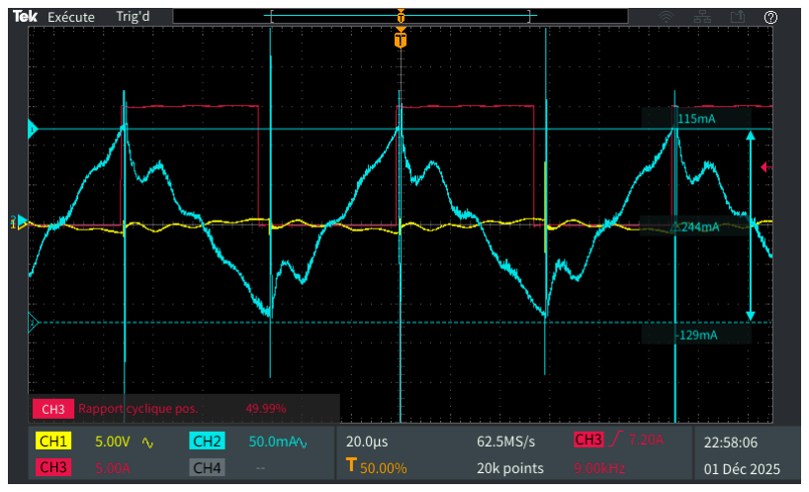
[picture p22: figure]
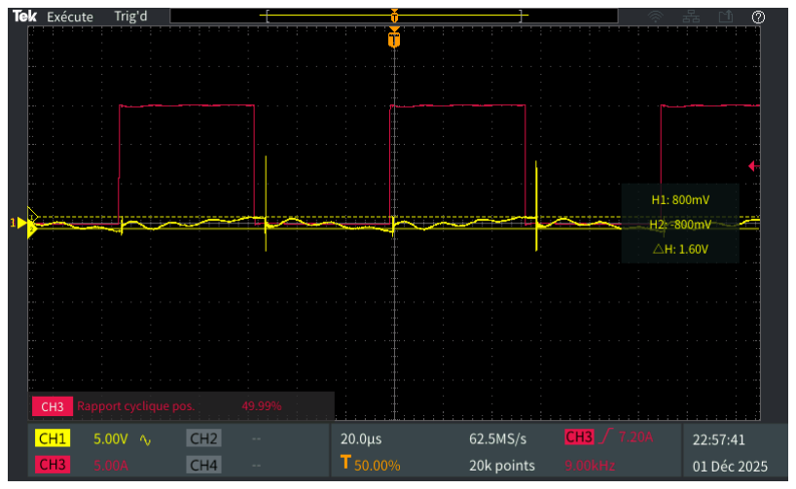
[picture p23: figure]

Figure 20 : Validation du dimensionnement avant le câblage final (Courant boost à gauche, tension Buck à droite).

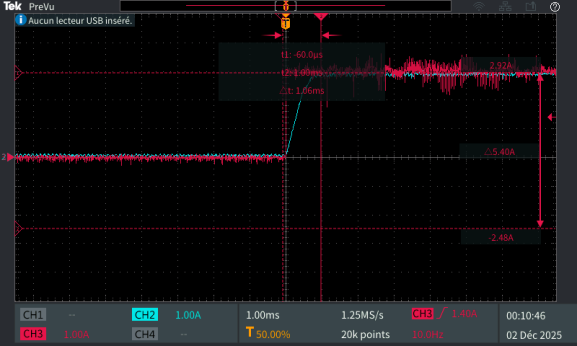
[picture p24: figure]

Figure 21 : Courant boost asservi (Manipulation).

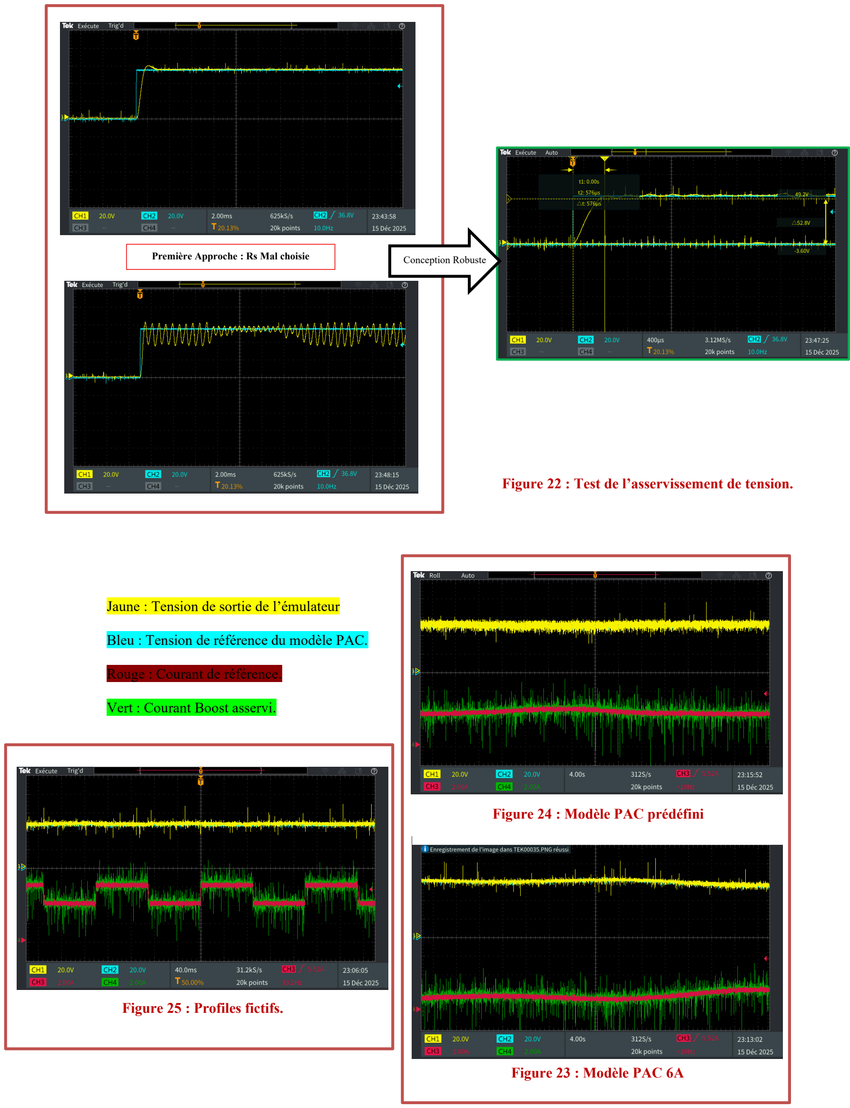
[picture p25: page 29]

Jaune : Tension de sortie de l’émulateur

Bleu : Tension de référence du modèle PAC.

Rouge : Courant de référence.

Vert : Courant Boost asservi.

Conception Robuste Première Approche : Rs Mal choisie

Figure 25 : Profiles fictifs.

Figure 24 : Modèle PAC prédéfini

Figure 22 : Test de l’asservissement de tension.

Figure 23 : Modèle PAC 6A

## Travaux futurs

- Une analyse plus rigoureuse des différentes stratégies de gestion du flux d’énergie.
- Des recherches supplémentaires sur les modèles de dégradation des piles à

combustible.

- D’autres topologies HIL pour la pile à combustible seront explorées, par exemple

l’approche par schéma électrique, qui présente l’avantage de ne générer aucune

ondulation de courant ou de tension, à l’exception de celles induites par le Boost.

- Meilleure analyse quantitative de l’asservissement (Goodness of fit entre le modèle

et la sortie de l’émulateur).

## Conclusion

Le projet « Fuel Cell Electric Vehicle Emulation » a permis de concevoir et de mettre en

œuvre un émulateur de pile à combustible destiné à une application de type FCEV. Le

travail réalisé repose sur la modélisation électrique de la pile à combustible sous conditions

nominales, ainsi que sur la conception et la commande de convertisseurs DC–DC

permettant de reproduire son comportement électrique de manière réaliste.

L’utilisation conjointe des convertisseurs Buck et Boost a permis d’assurer l’émulation de

la pile à combustible et son interface avec un bus continu modélisé comme une source de

tension idéale. Le système développé constitue ainsi une plateforme pédagogique

pertinente pour l’étude du fonctionnement des piles à combustible et des convertisseurs de

puissance associés, dans un cadre simple et contrôlé.

Ce projet permet de mieux comprendre le rôle et les contraintes de fonctionnement d’une

pile à combustible dans une architecture de type FCEV. Il offre également une base de

travail pouvant être enrichie ultérieurement par l’intégration de modèles plus détaillés ou

par l’amélioration des lois de commande.

## References

[1] H. Fathabadi, « Combining a proton exchange membrane fuel cell (PEMFC) stack with a Li-ion battery to supply the power needs of a hybrid electric vehicle », Renew. Energy, vol. 130, p. 714‑724, janv. 2019, doi: 10.1016/j.renene.2018.06.104.
[2] H. E. Wesseling, « Influence of Current Ripple on Proton Exchange Membrane Fuel Cell Degradation ».
[3] E. Pahon, M.-C. Péra, D. Bouquain, et D. Hissel, « Impact of current ripples on the durability of proton exchange membrane fuel cells based on two ageing datasets », Data Brief, vol. 45, p. 108601, déc. 2022, doi: 10.1016/j.dib.2022.108601.
[4] D. A. Desreveaux, « Fuel Cell Electric Vehicle emulation ».
[5] K. Bıkmaz, « Li-ion batteries vs photovoltaic – regenerative hydrogen fuel cell: Comprehensive review », Int. J. Energy Appl. Technol., vol. 11, no
1, p. 100‑107, déc.
2025, doi: 10.31593/ijeat.1730316.
[6] A. R. Kabi et O. Hari Gupta, « Comparative analysis of Fuel Cell and Battery energy storages for rooftop PV systems », in 2025 IEEE 5th International Conference on Sustainable Energy and Future Electric Transportation (SEFET), Jaipur, India: IEEE, juill. 2025, p. 1‑6. doi: 10.1109/SEFET65155.2025.11255533.
[7] « Proton Exchange Membrane Fuel Cell Transient Load Response ».
[8] A. S. Samosir, M. Anwari, et A. H. M. Yatim, « A simple PEM fuel cell emulator using electrical circuit model », in 2010 Conference Proceedings IPEC, Singapore, Singapore: IEEE, oct. 2010, p. 881‑885. doi: 10.1109/IPECON.2010.5697090.
[9] Á. Hernández-Gómez, D. Langarica-Cordoba, P. R. Martinez-Rodriguez, D. Guilbert, V. Ramirez, et B. Saldivar, « PEM Fuel Cell Emulators: A Review », Electronics, vol. 12, no
13, p. 2812, juin 2023, doi: 10.3390/electronics12132812.
[10] A. Rudra, P. S. Kulkarni, T. Sneha, et S. Ghosh, « Modelling and Analysis of a Fuel Cell Emulator for Integration in a Hybrid Photovoltaic System Using MATLAB-Simulink », in 2024 IEEE International Conference on Electronics, Computing and Communication Technologies (CONECCT), Bangalore, India: IEEE, juill. 2024, p. 1‑6. doi: 10.1109/CONECCT62155.2024.10677139.
[11] A. Desreveaux et al., « Analytical solution for fuel cell electric vehicle energy management including a long-term predefined velocity profile », Int. J. Hydrog. Energy, vol. 194, p. 152318, déc. 2025, doi: 10.1016/j.ijhydene.2025.152318.

## Annexe

Lien du répertoire GitHub :

- PEMFC-Battery-HESS-FCEV-HIL-Simulation-Project (https://github.com/azinedine456/PEMFC-Battery-HESS-FCEV-HIL-Simulation-Project)
