azinedine456/PEMFC-Battery-HESS-FCEV-HIL-Simulation-Project/PAC projets/PAC Projet (Dossier Complet)/November Scripts/LTSPICEFiles/Draft1.asc

B1: bv; V=V(out)
C1: cap; {C}
D1: diode; IDI
L1: ind; {L}
R1: res; 3
S1: sw; IDEAL
U1: PWM; Vin1=0 Vin2=1 Tperiod=1e-4; Tdelay=0 tripdt=Tdead
U2: ComplementaryBufferWithDeadtime; Tdead={Tdead} tripdt={Tdead} *0.5
U3: ComplementaryBufferWithDeadtime; Tdead={Tdead} tripdt={Tdead} *0.5
U4: sub
U5: Integral; T={1/1.5}
U6: Proportional; K=0.00075
U7: add
V1: voltage; {E}
V2: voltage; PULSE(0 100 0 10p 10p 50e-3 100e-3)
Named nets: vc1, vc2, mod, 0, out, m*_p, m*_i, cons, mes, diff
.param L=0.005 E=200 C=1.25e-6 Tdead=10p Rdson=10p Roc=10e6
.tran 0 300e-3 140e-3 1e-6
.model IDI D(Ron=Rdson Roff=Roc Vfwd=0)
.model IDEAL SW(Ron=Rdson,Roff=Roc,Vt=0.5)
Controller
