azinedine456/PEMFC-Battery-HESS-FCEV-HIL-Simulation-Project/PAC projets/PAC Projet (Dossier Complet)/November Scripts/LTSPICEFiles/Draft3.asc

B1: bv; V=I(L1)
B2: bv; V=E/(V(out))
D1: diode; IDI
I1: current; PULSE(0 20 0 10p 10p 50e-3 100e-3)
Icons: voltage; 0
L1: ind; {L}
S1: sw; IDEAL
U1: PWM; Vin1=0 Vin2=1 Tperiod=1e-4; Tdelay=0 tripdt=Tdead
U2: ComplementaryBufferWithDeadtime; Tdead={Tdead} tripdt={Tdead} *0.5
U3: ComplementaryBufferWithDeadtime; Tdead={Tdead} tripdt={Tdead} *0.5
U4: sub
U5: Integral
U6: Proportional; K=-0.0135
U7: add
U8: add
V1: voltage; {E}
V2: voltage; PULSE(0 20 0 10p 10p 50e-3 100e-3)
V3: voltage; {Vnom}
Named nets: vc1, vc2, mod, 0, out, m*_p, m*_i, cons, mes, diff
.param L=0.0045 E=45 C=50e-6 Tdead=10p Rdson=1e-2 Roc=10e6 Vnom=100 Rl=1e-3
.tran 0 300e-3 140e-3 1e-6
.model IDI D(Ron=Rdson Roff=Roc Vfwd=0)
.model IDEAL SW(Ron=Rdson,Roff=Roc,Vt=0.5)
Controller
Target Current Display
