azinedine456/PEMFC-Battery-HESS-FCEV-HIL-Simulation-Project/PAC projets/PAC Projet (Dossier Complet)/November Scripts/LTSPICEFiles/Draft4.asc

B2: bv; V=if(abs(V(line))>Vbreakdown,1,0)
B3: bv; V=if(V(vcg)&V(tim),1,0)
C1: cap; 1µ
C2: cap; 10n
L1: ind2; 1m
L2: ind2; 0.1
R1: res; {Rline}
S1: sw; MySwitch
SparkgapCurrent1: bi; I=if(V(cont)>0,I(S1),0)
V1: voltage; SINE(0 10k 50 0 0 0)
V2: voltage; PULSE(0 1 0.5m 10p 10p 1m 2m)
Named nets: 2, 1, 0, line, vcg, tim, cont
K L1 L2 0.08
.tran 0 0.110 0 1e-6
.param Vbreakdown=7k slope=0 Rspark=3 Rline=0.01
.ic V(vcg)=0
.model MySwitch SW(Ron=Rspark Roff=1Meg Vt=0.5)
